FelixAhrens/BBQ-Controller-Esp32-Blynk/PCB/electrical_circuit_image.png

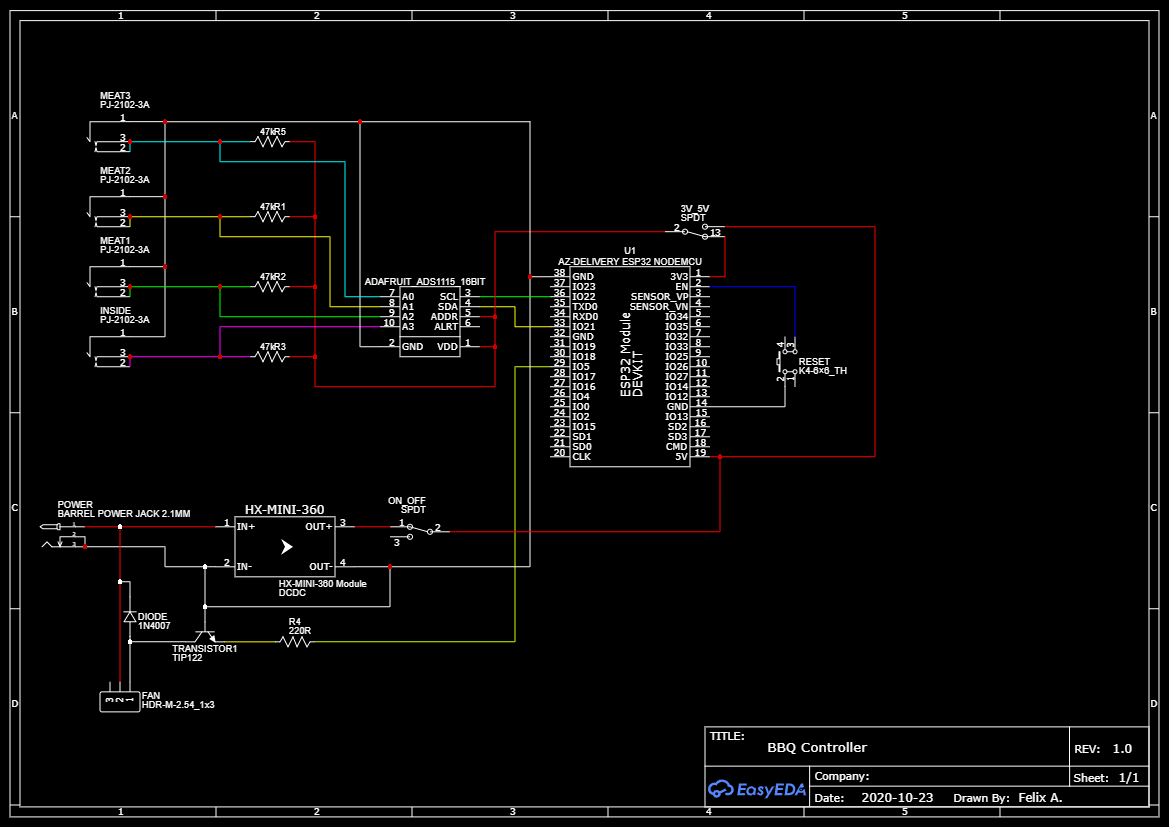
PCB/electrical_circuit_image.png
