FelixAhrens/BBQ-Controller-Esp32-Blynk/PCB/PCB_design_image.png

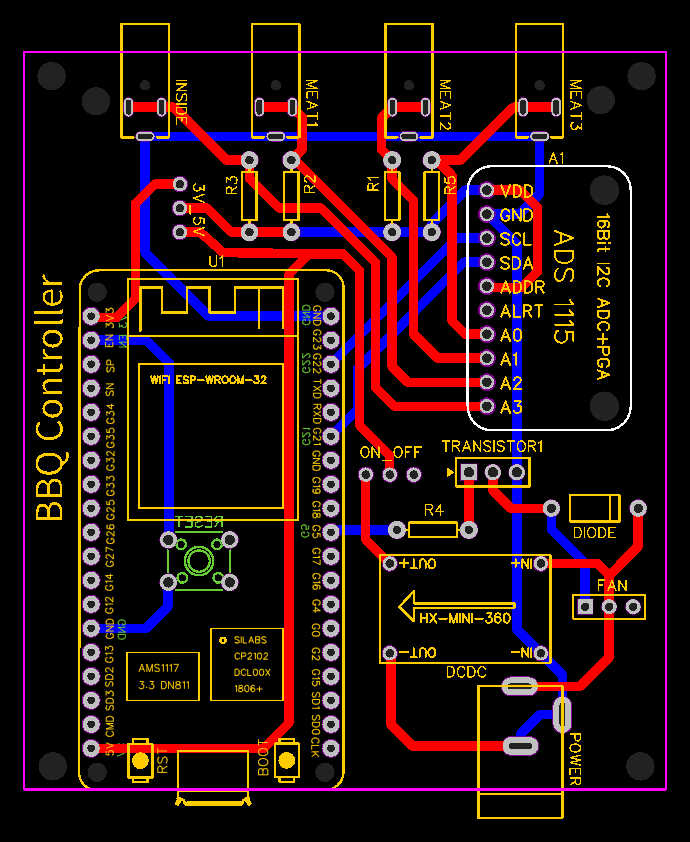
PCB/PCB_design_image.png
