FelixAhrens/BBQ-Controller-Esp32-Blynk/Case/21_bbq_controller_complete.stl

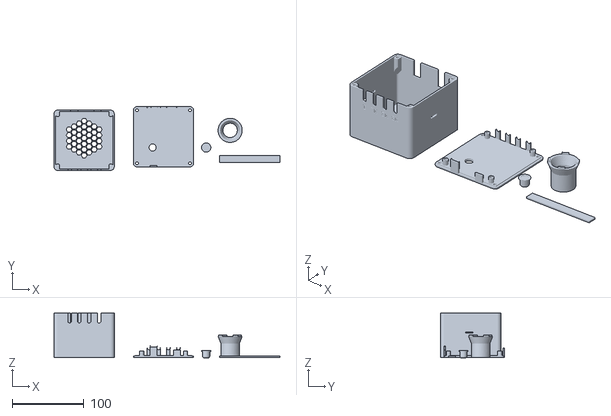
[picture p3: CAD file, 2021-06-22]
Case/21_bbq_controller_complete.stl
315.0 x 88.8 x 62.4
