FelixAhrens/BBQ-Controller-Esp32-Blynk/Case/21_bbq_controller_button_4-5.stl

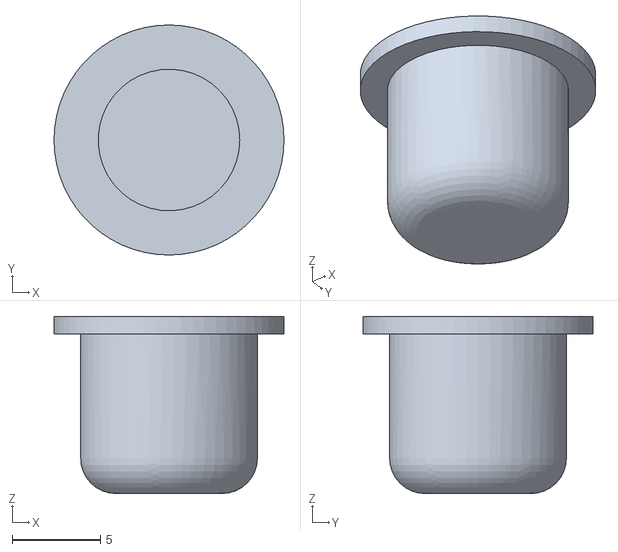
[picture p4: CAD file, 2021-06-22]
Case/21_bbq_controller_button_4-5.stl
13.0 x 13.0 x 10.0
