FelixAhrens/BBQ-Controller-Esp32-Blynk/Case/21_bbq_controller_case_1-5.stl

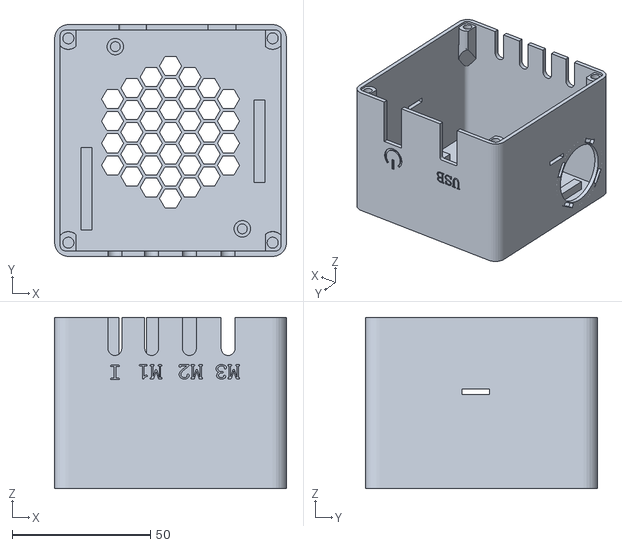
[picture p5: CAD file, 2021-06-22]
Case/21_bbq_controller_case_1-5.stl
84.0 x 84.0 x 62.0
