FelixAhrens/BBQ-Controller-Esp32-Blynk/Case/21_bbq_controller_funnel_3-5.stl

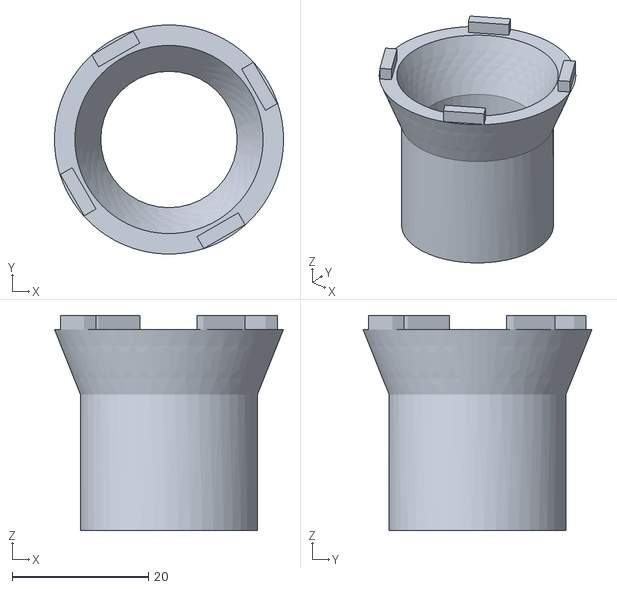
[picture p6: CAD file, 2021-06-22]
Case/21_bbq_controller_funnel_3-5.stl
33.6 x 33.6 x 31.6
