FelixAhrens/BBQ-Controller-Esp32-Blynk/Case/21_bbq_controller_fan_holder_5_5.stl

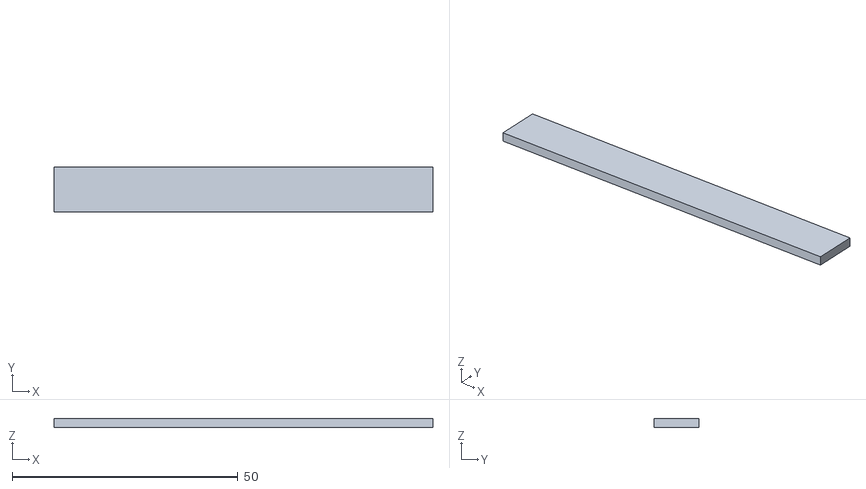
[picture p7: CAD file, 2021-06-22]
Case/21_bbq_controller_fan_holder_5_5.stl
84.0 x 10.0 x 2.00
