FelixAhrens/BBQ-Controller-Esp32-Blynk/(list of files, drawings)

Other design files:
PCB/JSON/PCB_BBQ Controller with ADC and 4 Probs.json
PCB/JSON/Schematic_BBQ Controller with ADC and 4 Probs.json
